tim23x/PicoCoffeeZanussi/CAD/Neopixel button holder-Body.step

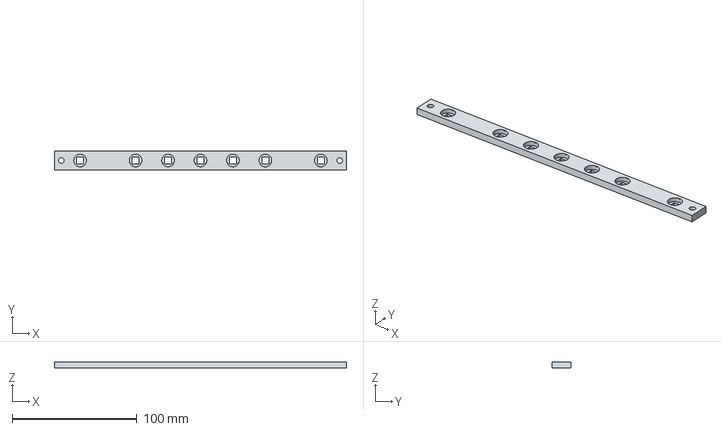
[picture p1: CAD file, 2026-11-07]
CAD/Neopixel button holder-Body.step
234.0 x 15.2 x 5.00 mm
