tim23x/PicoCoffeeZanussi/CAD/Switch mount.STEP

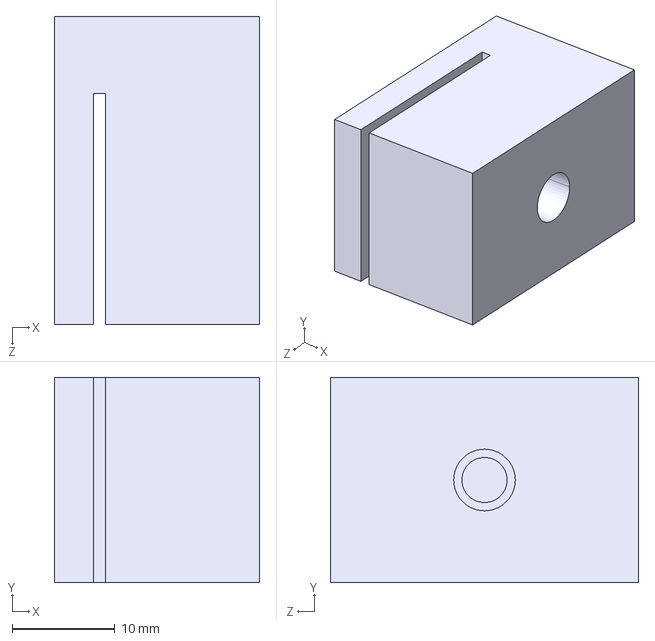
[picture p2: CAD file, 2026-11-01]
CAD/Switch mount.STEP
20.0 x 20.0 x 30.0 mm
