tim23x/PicoCoffeeZanussi/CAD/Case template.STEP

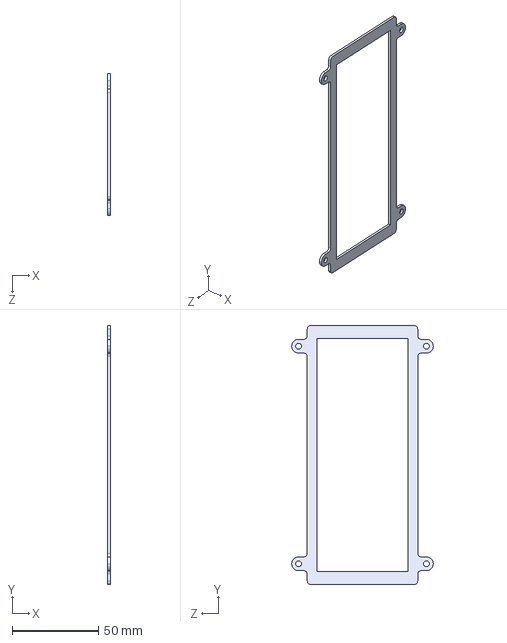
[picture p3: CAD file, 2026-11-01]
CAD/Case template.STEP
1.50 x 150.0 x 82.0 mm
