tim23x/PicoCoffeeZanussi/CAD/Pico and relays case 2.FCStd

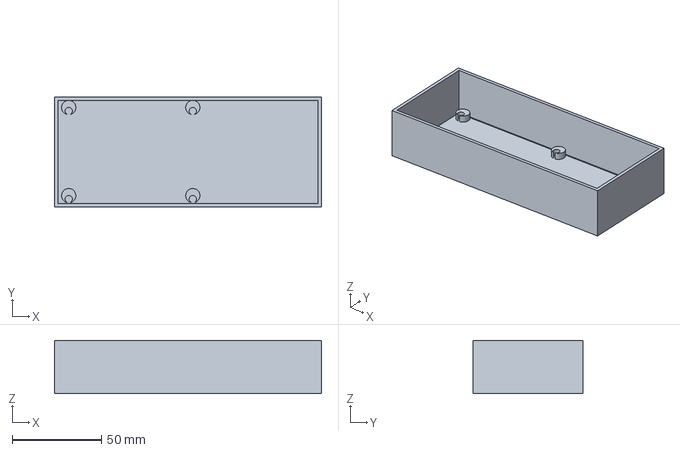
[picture p4: CAD file, 2026-10-30]
CAD/Pico and relays case 2.FCStd
150.0 x 62.0 x 30.0 mm
