tim23x/PicoCoffeeZanussi/CAD/Button adapter.FCStd

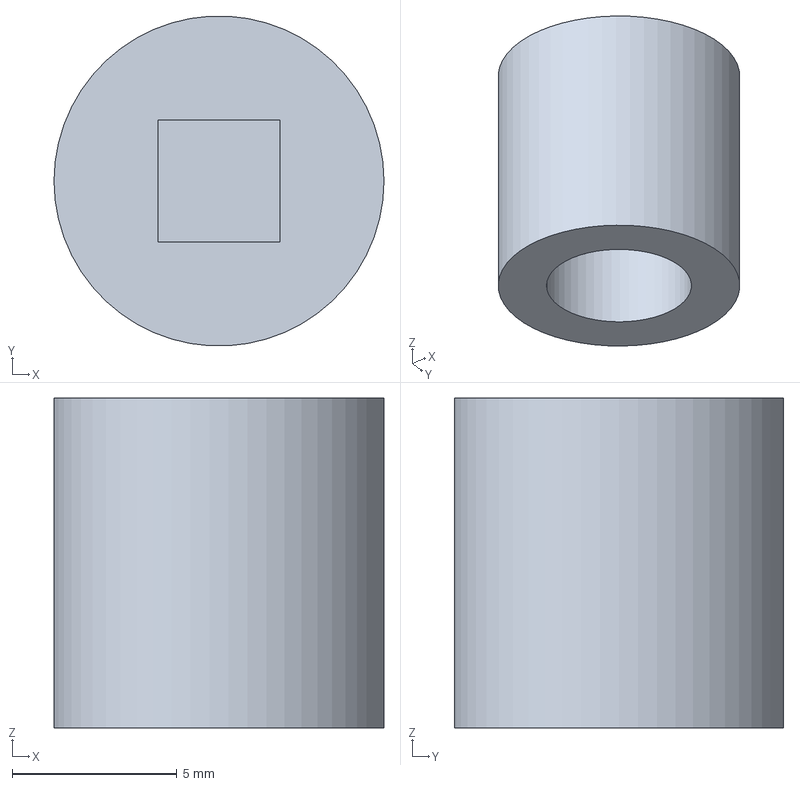
[picture p5: CAD file, 2026-10-30]
CAD/Button adapter.FCStd
10.0 x 9.98 x 10.0 mm
