tim23x/PicoCoffeeZanussi/CAD/Neopixel ring holder-Body.step

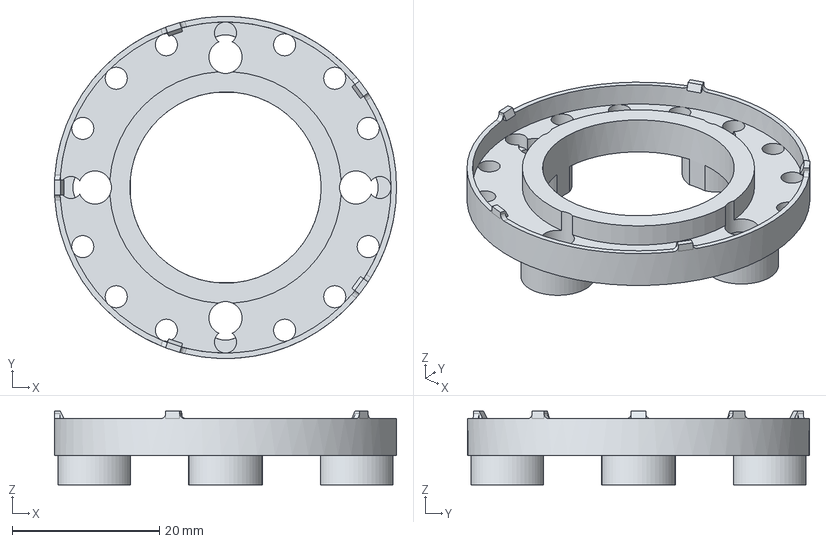
[picture p6: CAD file, 2026-10-30]
CAD/Neopixel ring holder-Body.step
46.5 x 46.5 x 10.0 mm
