tim23x/PicoCoffeeZanussi/CAD/Case.STEP

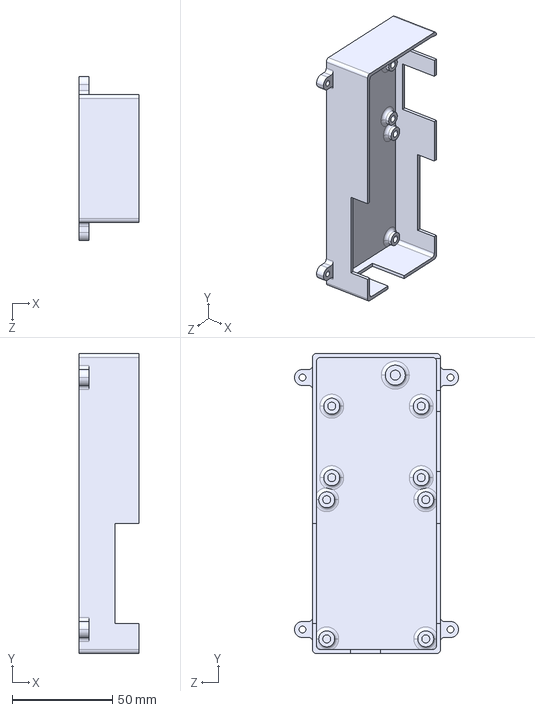
[picture p7: CAD file, 2026-10-30]
CAD/Case.STEP
30.0 x 150.0 x 82.0 mm
