tim23x/PicoCoffeeZanussi/CAD/Body.3mf

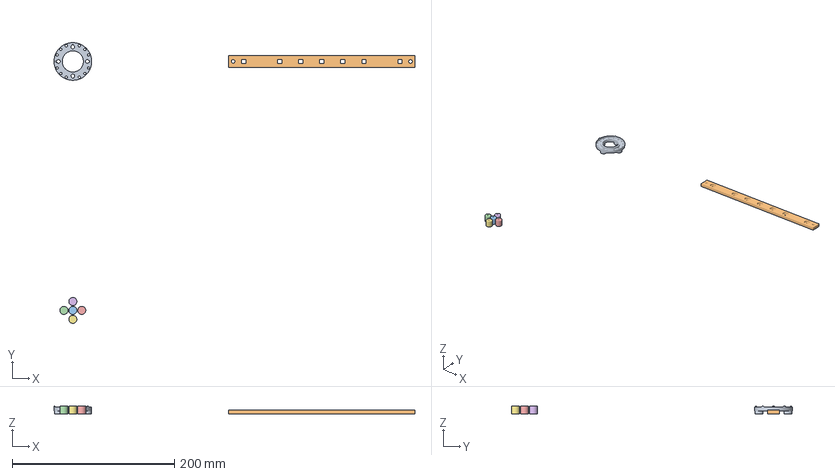
[picture p8: CAD file, 2026-10-30]
CAD/Body.3mf
445.5 x 346.4 x 10.0 mm
