tim23x/PicoCoffeeZanussi/CAD/Pico and relays case-Body.step

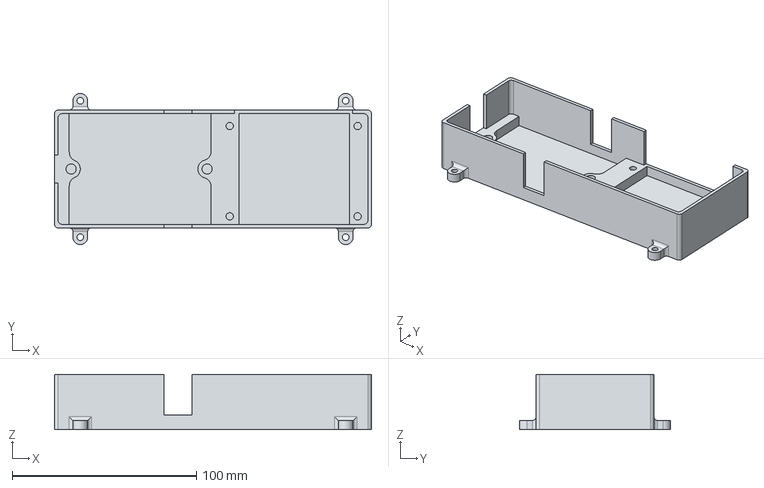
[picture p9: CAD file, 2026-10-21]
CAD/Pico and relays case-Body.step
172.0 x 82.0 x 30.0 mm
