tim23x/PicoCoffeeZanussi/CAD/Case-Body.step

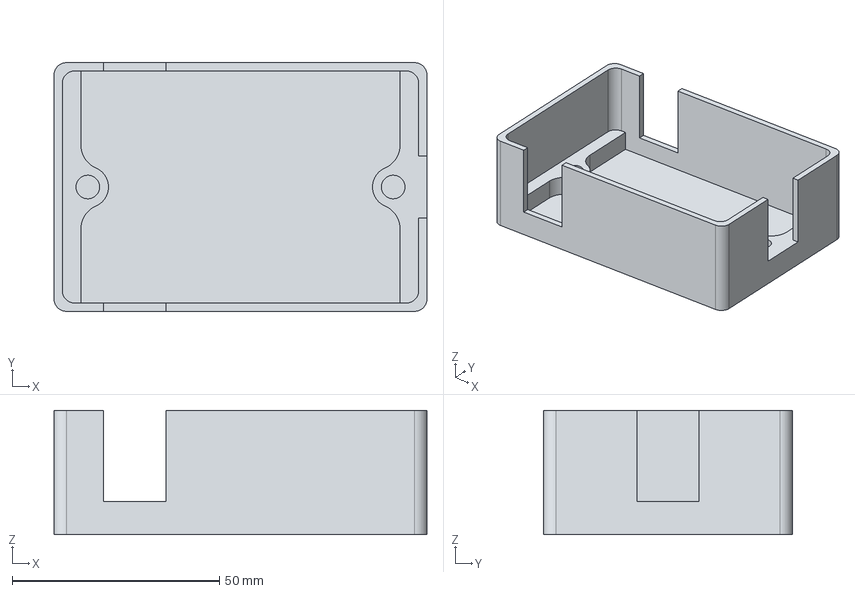
[picture p10: CAD file, 2026-10-21]
CAD/Case-Body.step
90.0 x 60.0 x 30.0 mm
