tim23x/PicoCoffeeZanussi/CAD/Relay x4 case.FCStd

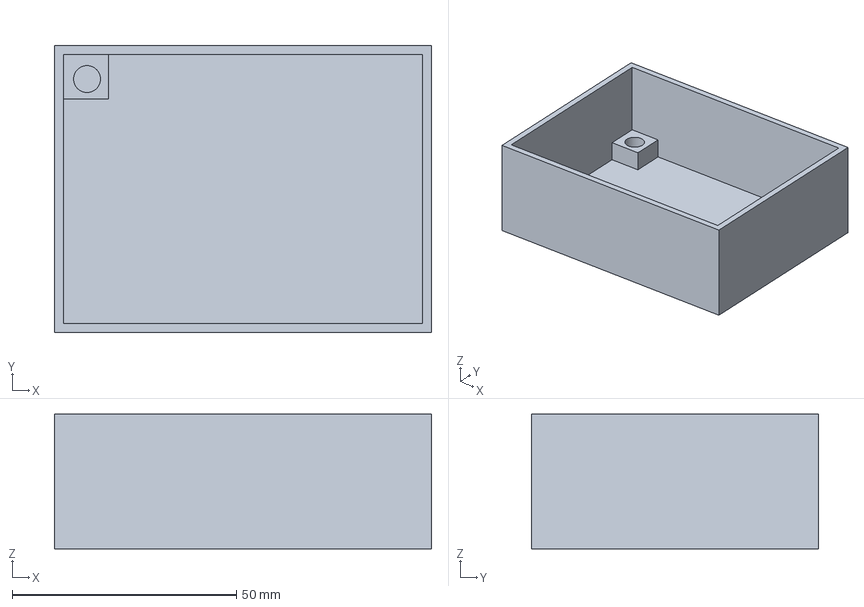
[picture p11: CAD file, 2026-10-21]
CAD/Relay x4 case.FCStd
84.0 x 64.0 x 30.0 mm
