tim23x/PicoCoffeeZanussi/(list of files, cad)

Other CAD files:
CAD/Neopixel button holder.FCStd
CAD/Neopixel ring holder.FCStd
CAD/Button adapter-Body.step
CAD/Pico and relays case.FCStd
CAD/Case-Body.3mf
CAD/Case.FCStd
CAD/Case.SLDPRT
CAD/Neopixel button holder.3mf
