tim23x/PicoCoffeeZanussi/lwipopts.h

// lwIP options for the web interface: no OS, polled from the main loop (pico_cyw43_arch_lwip_poll).

#ifndef LWIPOPTS_H
#define LWIPOPTS_H

#define NO_SYS                      1
#define LWIP_SOCKET                 0
#define LWIP_NETCONN                0
#define MEM_LIBC_MALLOC             0
#define MEM_ALIGNMENT               4
#define MEM_SIZE                    16000
#define MEMP_NUM_TCP_SEG            32
#define MEMP_NUM_ARP_QUEUE          10
#define PBUF_POOL_SIZE              24

#define LWIP_ARP                    1
#define LWIP_ETHERNET               1
#define LWIP_ICMP                   1
#define LWIP_RAW                    1
#define LWIP_IPV4                   1
#define LWIP_TCP                    1
#define LWIP_UDP                    1
#define LWIP_DNS                    1
#define LWIP_DHCP                   1
#define DHCP_DOES_ARP_CHECK         0
#define LWIP_DHCP_DOES_ACD_CHECK    0

#define TCP_MSS                     1460
#define TCP_WND                     (8 * TCP_MSS)
#define TCP_SND_BUF                 (8 * TCP_MSS)
#define TCP_SND_QUEUELEN            ((4 * (TCP_SND_BUF) + (TCP_MSS - 1)) / (TCP_MSS))
#define LWIP_TCP_KEEPALIVE          1

#define LWIP_NETIF_STATUS_CALLBACK  1
#define LWIP_NETIF_LINK_CALLBACK    1
#define LWIP_NETIF_HOSTNAME         1
#define LWIP_NETIF_TX_SINGLE_PBUF   1
#define LWIP_CHKSUM_ALGORITHM       3

// mDNS, so the machine answers as zanussi.local
#define LWIP_IGMP                       1
#define LWIP_MDNS_RESPONDER             1
#define LWIP_NUM_NETIF_CLIENT_DATA      1
#define LWIP_NETIF_EXT_STATUS_CALLBACK  1
#define MDNS_MAX_SERVICES               1
#define MEMP_NUM_UDP_PCB                6
#define MEMP_NUM_SYS_TIMEOUT            (LWIP_NUM_SYS_TIMEOUT_INTERNAL + 7)

// SNTP for the date (seasonal tunes). clock_set_unix() is in PicoCoffeeZanussi.cpp.
#include <stdint.h>
#ifdef __cplusplus
extern "C"
#endif
void clock_set_unix(uint32_t unix_s);
#define SNTP_SERVER_DNS                 1
#define SNTP_SET_SYSTEM_TIME(sec)       clock_set_unix(sec)

// MQTT for Home Assistant: discovery messages are up to ~500 bytes each
#define MQTT_OUTPUT_RINGBUF_SIZE        2048
#define MQTT_VAR_HEADER_BUFFER_LEN      256
#define MQTT_REQ_MAX_IN_FLIGHT          8

#define LWIP_STATS                  0
#define LWIP_STATS_DISPLAY          0
#define LWIP_DEBUG                  0

#endif
