tim23x/PicoCoffeeZanussi/(commit log)

2026-10-21 Added CAD files
    [Case-Body.3mf, Case-Body.step, Case.FCStd, Case.SLDPRT, Pico and relays case-Body.step, Pico and relays case.FCStd, Relay x4 case.FCStd]
2026-10-30 Added CAD and Neopixel ring test pattern
    [Body.3mf, Button adapter-Body.step, Button adapter.FCStd, Case.SLDPRT, Case.STEP, Neopixel button holder-Body.step, Neopixel button holder.FCStd, Neopixel ring holder-Body.step]
2026-11-01 Added delta-sigma PID control for heater
    [Case template.STEP, Case-Body.3mf, Switch mount.STEP]
2026-11-07 Updated neopixel behaviour, altered default settings
    [Neopixel button holder-Body.step, Neopixel button holder.3mf, Neopixel button holder.FCStd]
2026-11-08 Added I2S, long shots and fixed graph update rate.
    [PicoCoffeeZanussi.cpp, lwipopts.h]
